costarc/WonderTANG/kicad/WonderTANG.png

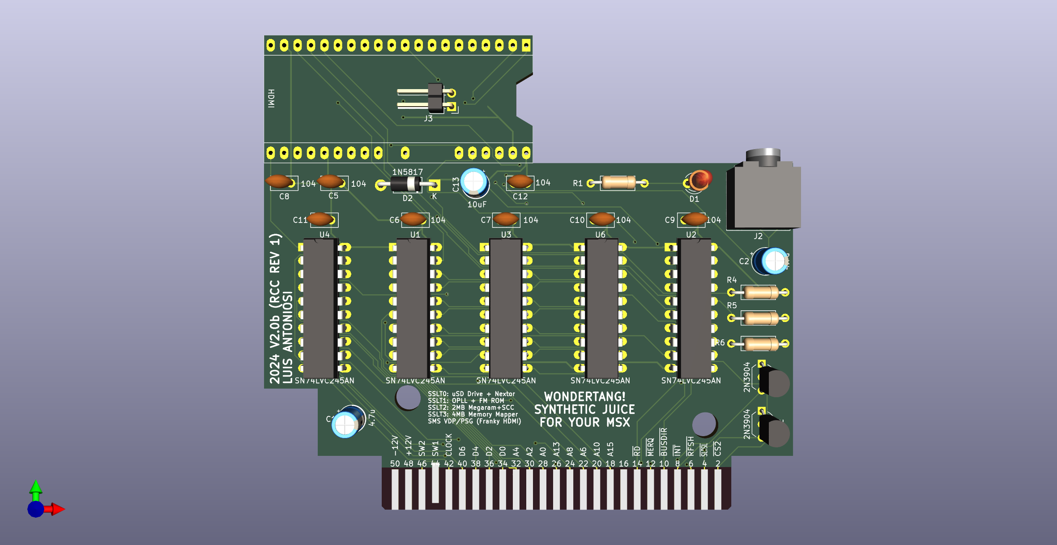
kicad/WonderTANG.png
