costarc/WonderTANG/kicad/WonderTANG.pdf

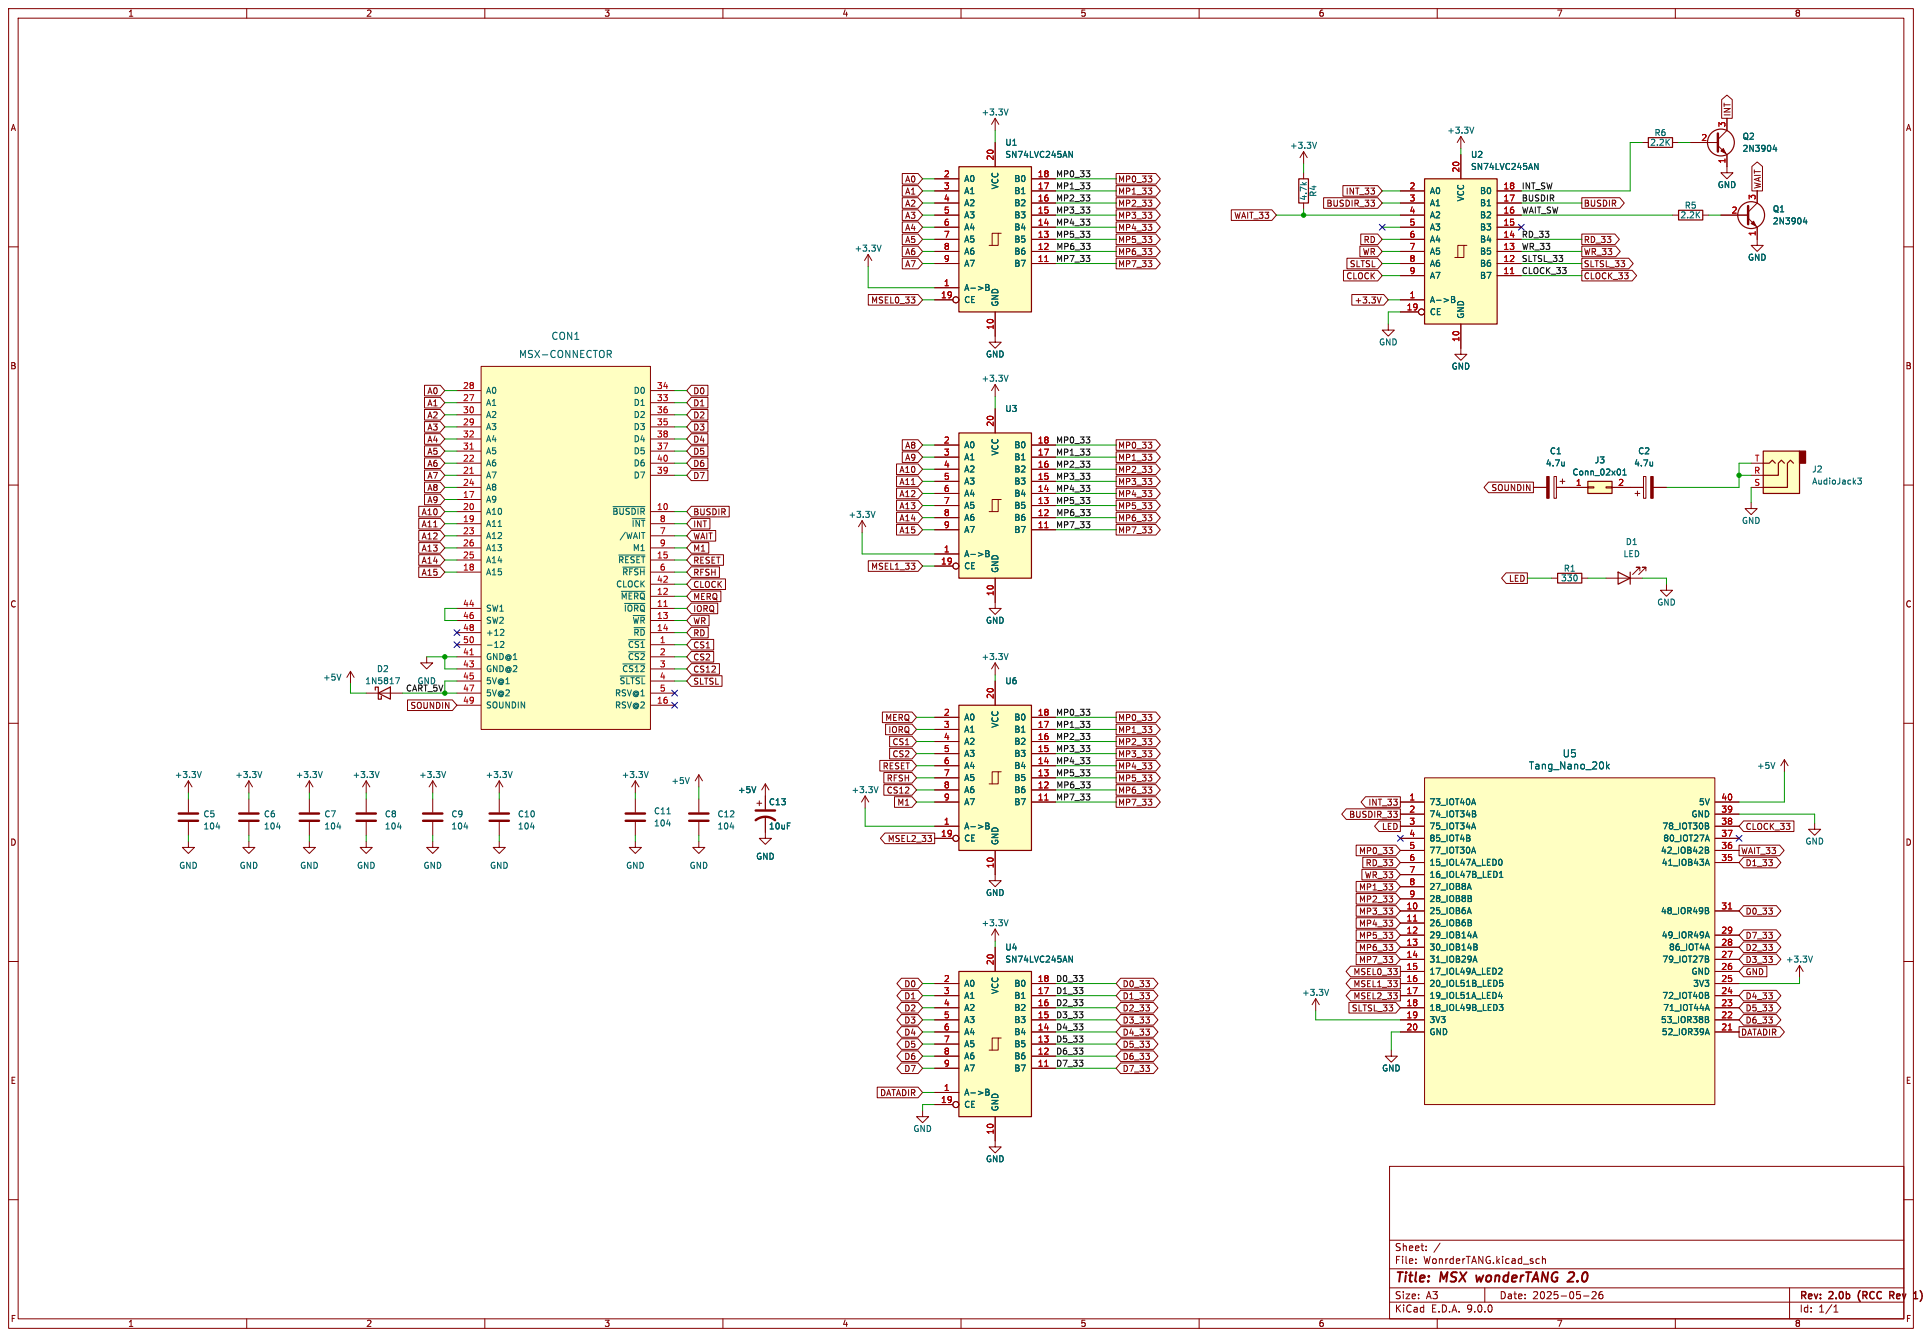
[picture p2: page 1]

File: WonrderTANG.kicad_sch Sheet: / GND

Id: 1/1 Title: MSX wonderTANG 2.0
