costarc/WonderTANG/kicad/WonderTANG.kicad_pcb

## KiCad design kicad/WonderTANG.kicad_pcb (2025-05-26)

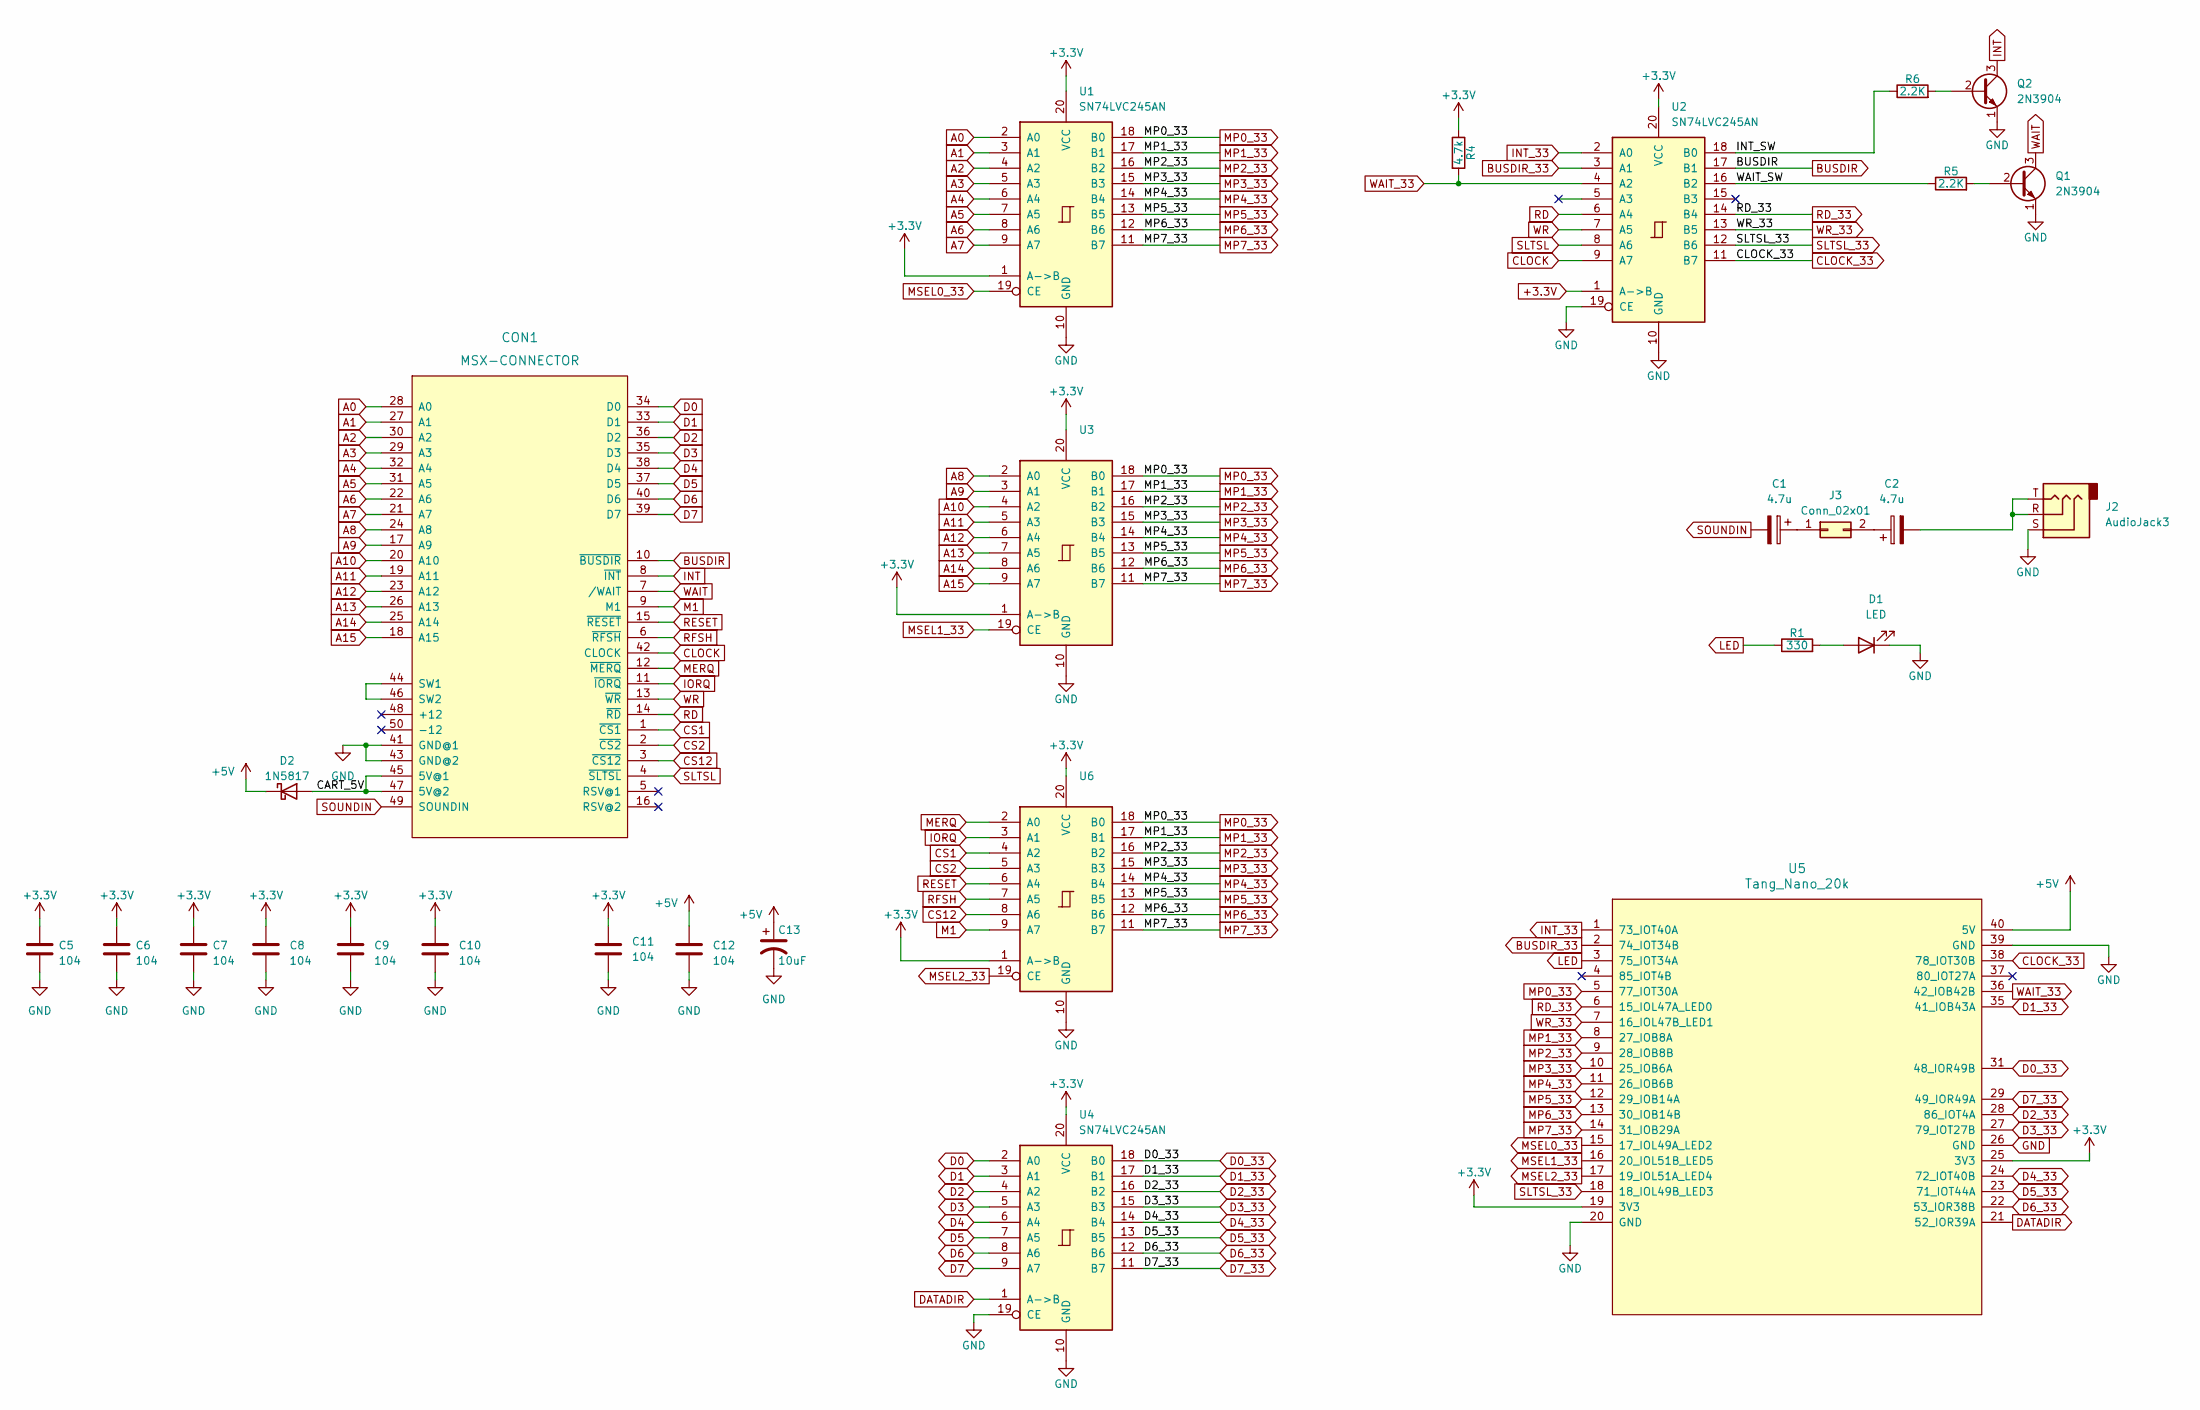
[picture p3: schematic WonderTANG.kicad_sch, MSX wonderTANG 2.0]

Parts:
C1, C2: 4.7u; CP_Radial_D5.0mm_P2.50mm
C5, C6, C7, C8, C9, C10, C11, C12: 104; C_Disc_D5.0mm_W2.5mm_P2.50mm
C13: 10uF; CP_Radial_D5.0mm_P2.00mm
CON1: MSX-CONNECTOR; CARTRIDGE_MSX_NOCUT
D1: LED; LED_D3.0mm
D2: 1N5817; D_DO-41_SOD81_P10.16mm_Horizontal
J2: AudioJack3; SJ1-3523N
J3: Conn_02x01; PinHeader_1x02_P2.54mm_Horizontal
Q1, Q2: 2N3904; TO-92_Inline_Wide
R1: 330; R_Axial_DIN0207_L6.3mm_D2.5mm_P10.16mm_Horizontal
R4: 4.7k; R_Axial_DIN0207_L6.3mm_D2.5mm_P10.16mm_Horizontal
R5, R6: 2.2K; R_Axial_DIN0207_L6.3mm_D2.5mm_P10.16mm_Horizontal
U1, U2, U3, U4, U6: SN74LVC245AN; DIP-20_W7.62mm_LongPads
U5: Tang_Nano_20k; Tang_Nano_20k_Audio

Connections:
+3.3V: C5.1, C6.1, C7.1, C8.1, C9.1, C10.1, C11.1, R4.1, U1.1 (A->B), U1.20 (VCC), U2.1 (A->B), U2.20 (VCC), U3.1 (A->B), U3.20 (VCC), U4.20 (VCC), U5.19 (3V3), U5.25 (3V3), U6.1 (A->B), U6.20 (VCC)
+5V: C12.1, C13.1, D2.1 (K), U5.40 (5V)
/CART_5V: CON1.45 (5V@1), CON1.47 (5V@2), D2.2 (A)
/INT_SW: R6.1, U2.18 (B0)
/WAIT_SW: R5.1, U2.16 (B2)
A0: CON1.28 (A0), U1.2 (A0)
A1: CON1.27 (A1), U1.3 (A1)
A2: CON1.30 (A2), U1.4 (A2)
A3: CON1.29 (A3), U1.5 (A3)
A4: CON1.32 (A4), U1.6 (A4)
A5: CON1.31 (A5), U1.7 (A5)
A6: CON1.22 (A6), U1.8 (A6)
A7: CON1.21 (A7), U1.9 (A7)
A8: CON1.24 (A8), U3.2 (A0)
A9: CON1.17 (A9), U3.3 (A1)
A10: CON1.20 (A10), U3.4 (A2)
A11: CON1.19 (A11), U3.5 (A3)
A12: CON1.23 (A12), U3.6 (A4)
A13: CON1.26 (A13), U3.7 (A5)
A14: CON1.25 (A14), U3.8 (A6)
A15: CON1.18 (A15), U3.9 (A7)
BUSDIR: CON1.10 (~BUSDIR), U2.17 (B1)
BUSDIR_33: U2.3 (A1), U5.2 (74_IOT34B)
CLOCK: CON1.42 (CLOCK), U2.9 (A7)
CLOCK_33: U2.11 (B7), U5.38 (78_IOT30B)
CS1: CON1.1 (~CS1), U6.4 (A2)
CS2: CON1.2 (~CS2), U6.5 (A3)
CS12: CON1.3 (~CS12), U6.8 (A6)
D0: CON1.34 (D0), U4.2 (A0)
D0_33: U4.18 (B0), U5.31 (48_IOR49B)
D1: CON1.33 (D1), U4.3 (A1)
D1_33: U4.17 (B1), U5.35 (41_IOB43A)
D2: CON1.36 (D2), U4.4 (A2)
D2_33: U4.16 (B2), U5.28 (86_IOT4A)
D3: CON1.35 (D3), U4.5 (A3)
D3_33: U4.15 (B3), U5.27 (79_IOT27B)
D4: CON1.38 (D4), U4.6 (A4)
D4_33: U4.14 (B4), U5.24 (72_IOT40B)
D5: CON1.37 (D5), U4.7 (A5)
D5_33: U4.13 (B5), U5.23 (71_IOT44A)
D6: CON1.40 (D6), U4.8 (A6)
D6_33: U4.12 (B6), U5.22 (53_IOR38B)
D7: CON1.39 (D7), U4.9 (A7)
D7_33: U4.11 (B7), U5.29 (49_IOR49A)
DATADIR: U4.1 (A->B), U5.21 (52_IOR39A)
GND: C5.2, C6.2, C7.2, C8.2, C9.2, C10.2, C11.2, C12.2, C13.2, CON1.41 (GND@1), CON1.43 (GND@2), D1.1 (K), J2.S, Q1.1 (E), Q2.1 (E), U1.10 (GND), U2.10 (GND), U2.19 (CE), U3.10 (GND), U4.10 (GND), U4.19 (CE), U5.20 (GND), U5.26 (GND), U5.39 (GND), U6.10 (GND)
INT: CON1.8 (~INT), Q2.3 (C)
INT_33: U2.2 (A0), U5.1 (73_IOT40A)
IORQ: CON1.11 (~IORQ), U6.3 (A1)
LED: R1.1, U5.3 (75_IOT34A)
M1: CON1.9 (M1), U6.9 (A7)
MERQ: CON1.12 (~MERQ), U6.2 (A0)
MP0_33: U1.18 (B0), U3.18 (B0), U5.5 (77_IOT30A), U6.18 (B0)
MP1_33: U1.17 (B1), U3.17 (B1), U5.8 (27_IOB8A), U6.17 (B1)
MP2_33: U1.16 (B2), U3.16 (B2), U5.9 (28_IOB8B), U6.16 (B2)
MP3_33: U1.15 (B3), U3.15 (B3), U5.10 (25_IOB6A), U6.15 (B3)
MP4_33: U1.14 (B4), U3.14 (B4), U5.11 (26_IOB6B), U6.14 (B4)
MP5_33: U1.13 (B5), U3.13 (B5), U5.12 (29_IOB14A), U6.13 (B5)
MP6_33: U1.12 (B6), U3.12 (B6), U5.13 (30_IOB14B), U6.12 (B6)
MP7_33: U1.11 (B7), U3.11 (B7), U5.14 (31_IOB29A), U6.11 (B7)
MSEL0_33: U1.19 (CE), U5.15 (17_IOL49A_LED2)
MSEL1_33: U3.19 (CE), U5.16 (20_IOL51B_LED5)
MSEL2_33: U5.17 (19_IOL51A_LED4), U6.19 (CE)
unnamed: C2.2, J2.R, J2.T
unnamed: CON1.44 (SW1), CON1.46 (SW2)
unnamed: D1.2 (A), R1.2
unnamed: C1.1, J3.1
unnamed: C2.1, J3.2
unnamed: Q1.2 (B), R5.2
unnamed: Q2.2 (B), R6.2
RD: CON1.14 (~RD), U2.6 (A4)
RD_33: U2.14 (B4), U5.6 (15_IOL47A_LED0)
RESET: CON1.15 (~RESET), U6.6 (A4)
RFSH: CON1.6 (~RFSH), U6.7 (A5)
SLTSL: CON1.4 (~SLTSL), U2.8 (A6)
SLTSL_33: U2.12 (B6), U5.18 (18_IOL49B_LED3)
SOUNDIN: C1.2, CON1.49 (SOUNDIN)
WAIT: CON1.7 (/WAIT), Q1.3 (C)
WAIT_33: R4.2, U2.4 (A2), U5.36 (42_IOB42B)
WR: CON1.13 (~WR), U2.7 (A5)
WR_33: U2.13 (B5), U5.7 (16_IOL47B_LED1)

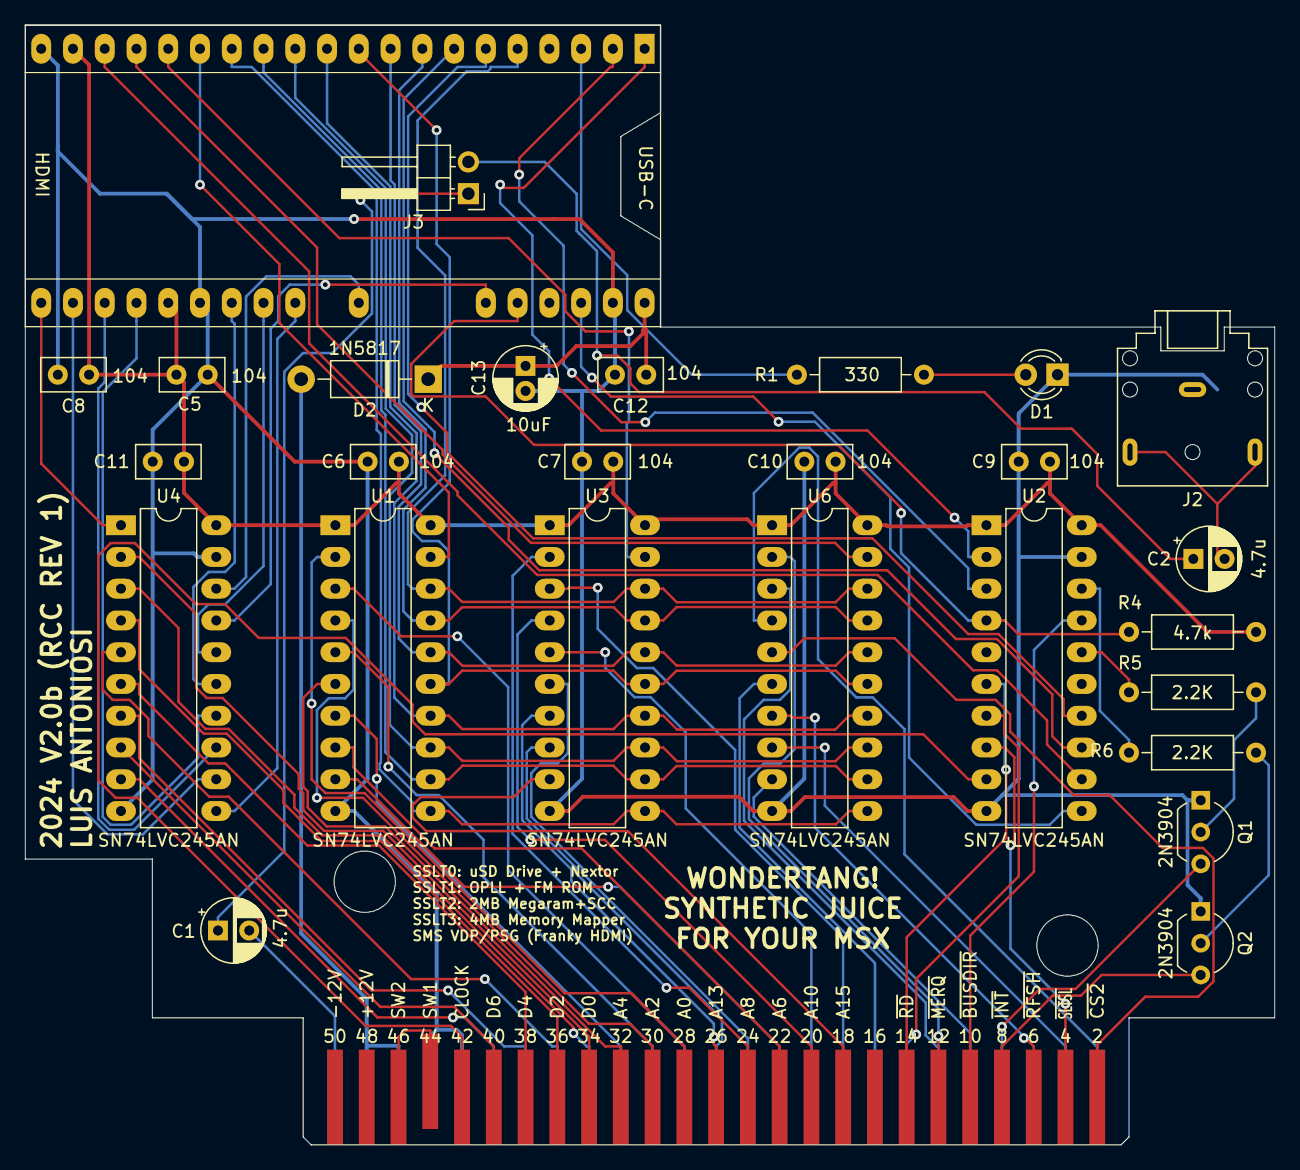
[picture p4: board WonderTANG.kicad_pcb from above]

Board: 2 copper layers, 99.9 x 89.5 mm, 28 parts (0 on the bottom side), 81 nets.
