costarc/WonderTANG/(commit log)

2024-07-06 Generated Gerbers for my modified version 20b_rcc_0
    [WonrderTANG.kicad_pcb, WonrderTANG.kicad_pcb_bom.csv, WonrderTANG.kicad_pcb_positions.csv]
2024-07-06 Moved pcbway gerbers into original Gerber folder
    [WonrderTANG-B_Mask.gbr, WonrderTANG-B_Silkscreen.gbr, WonrderTANG-Bottom.gbr, WonrderTANG-Edge_Cuts.gbr, WonrderTANG-F_Mask.gbr, WonrderTANG-F_Silkscreen.gbr, WonrderTANG-NPTH-drl_map.gbr, WonrderTANG-NPTH.drl]
2024-07-22 silk update
    [WonrderTANG.kicad_pcb, WonrderTANG.kicad_pcb_bom.csv, WonrderTANG.kicad_pcb_positions.csv]
2025-05-26 Version 2.0b RCC Rev1 - rotated J3 to better fit audio jumper
    [WonrderTANG.kicad_pcb, WonrderTANG.kicad_sch]
2025-05-26 Fixed typo in the project file names; exported Gerber 2.0b RCC Rev1
    [WonderTANG-B_Mask.gbs, WonderTANG-B_Silkscreen.gbo, WonderTANG-Bottom.gbl, WonderTANG-Edge_Cuts.gm1, WonderTANG-F_Mask.gts, WonderTANG-F_Silkscreen.gto, WonderTANG-Top.gtl, WonderTANG.drl]
